Viper7000/Voltronic_MQTT/Version_1.1.md

# Принципиальная схема устройства версии 1.1 с исправленными ошибками

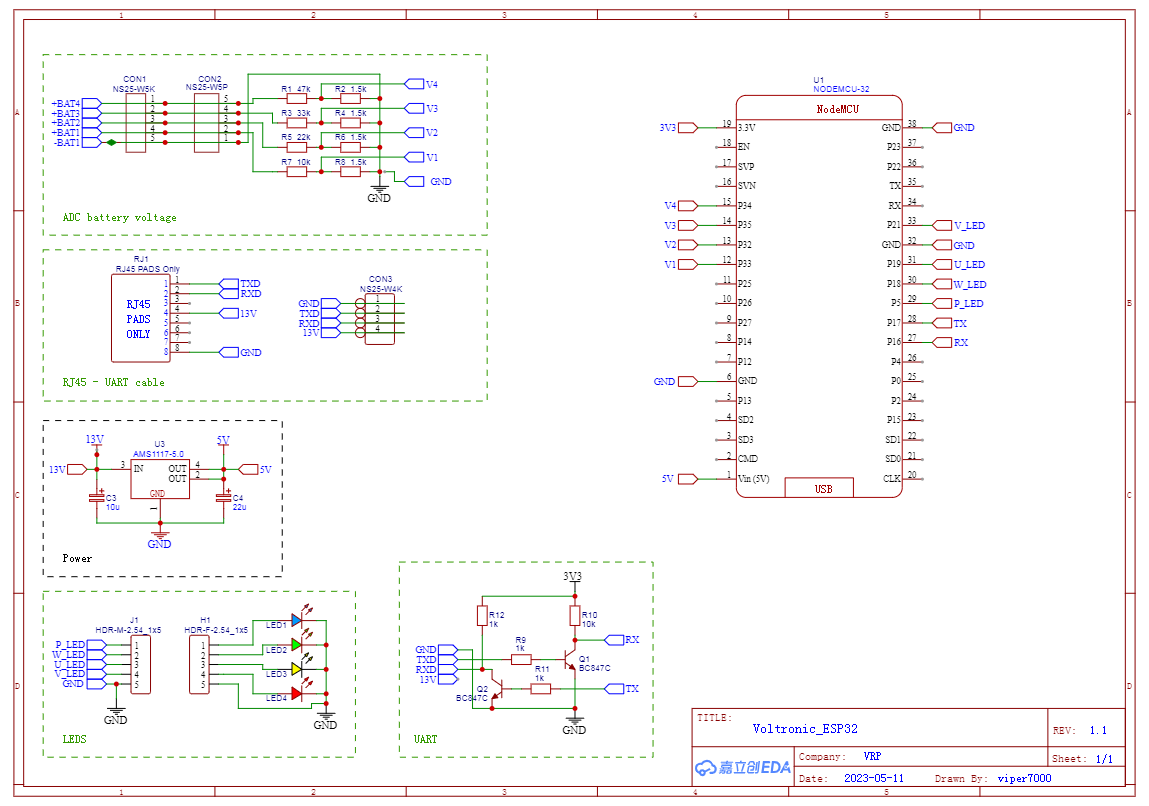
[picture p16: img/SCH_1.1.png]
схема принципиальная схема


## Печатная плата и сборка устройства

В папке prodaction есть [Gerber](production/Gerber_Voltronic_ESP32_v1.1.zip) для заказа печатной платы и [BOM](production/BOM_Board1_PCB1_2023-05-11.xlsx) файл компонентов.
Я заказзывал платы на https://jlcpcb.com . Изготовляем плату и собираем. Внешний вид платы на картинке.

плата вид впаты лицо
плата вид впаты изнанка

Для своего устройства я использовал корпус на DIN рейку шириной в 2 модуля. Спереди прозрачное стекло для установки вольтметров.

корпус корпус на DIN рейку

Внутрь на термоклей закрепил 4 вольтметра. Так же через отверстия вывел 4 диода. Закрепил тоже на термоклей.
Плата в сборе закрепляется на корпусе винтами.

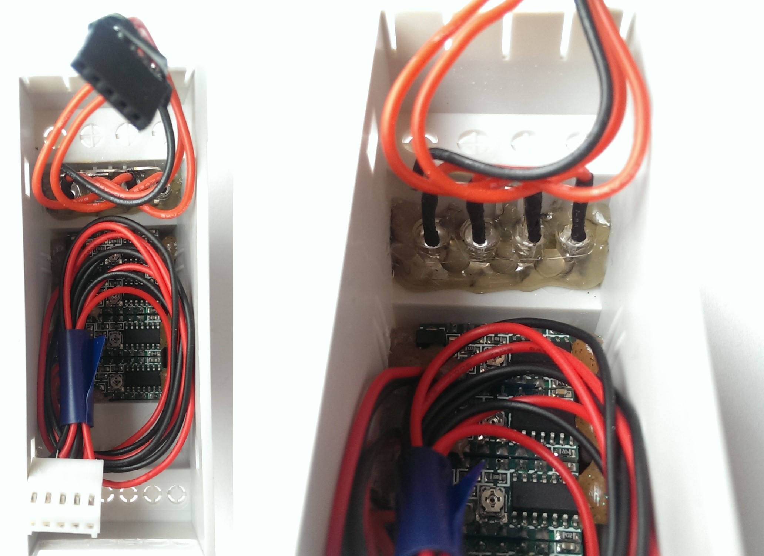
[picture p17: img/6.jpg]
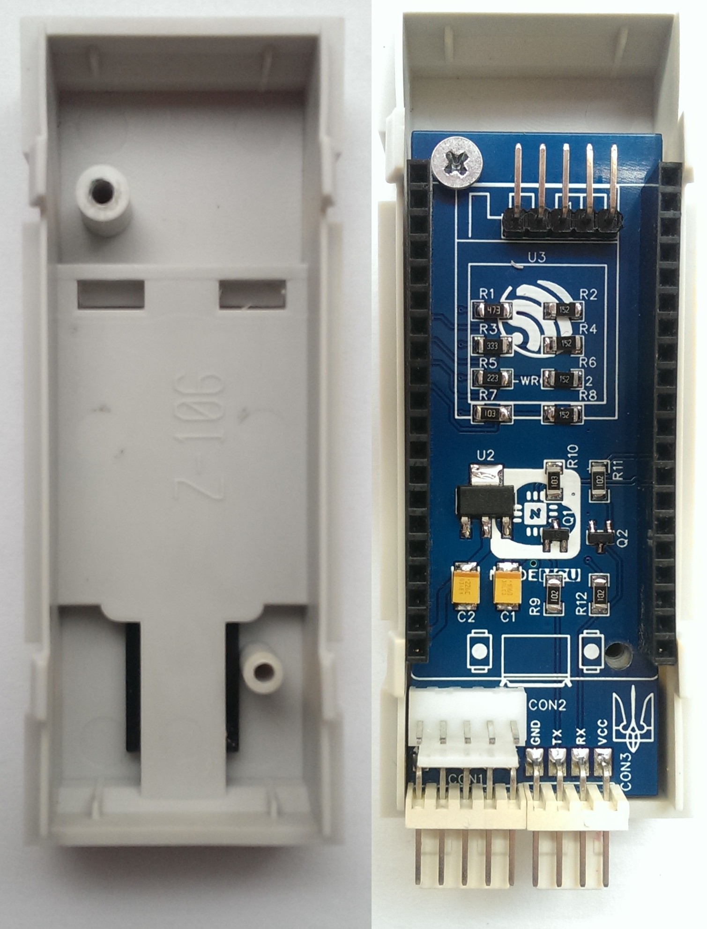
[picture p18: img/3.jpg]
 

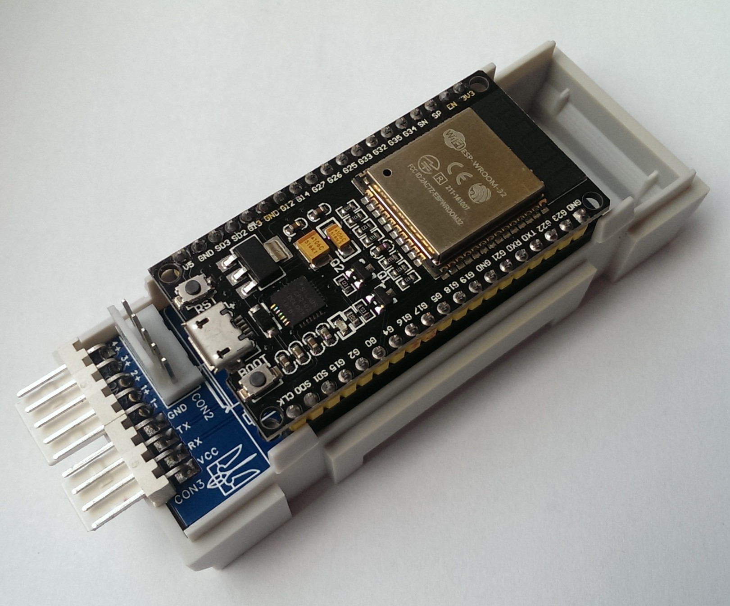
[picture p19: img/4.jpg]
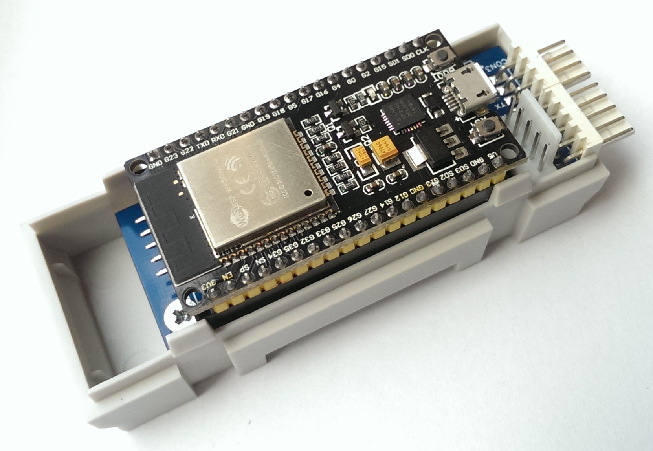
[picture p20: img/5.jpg]
 

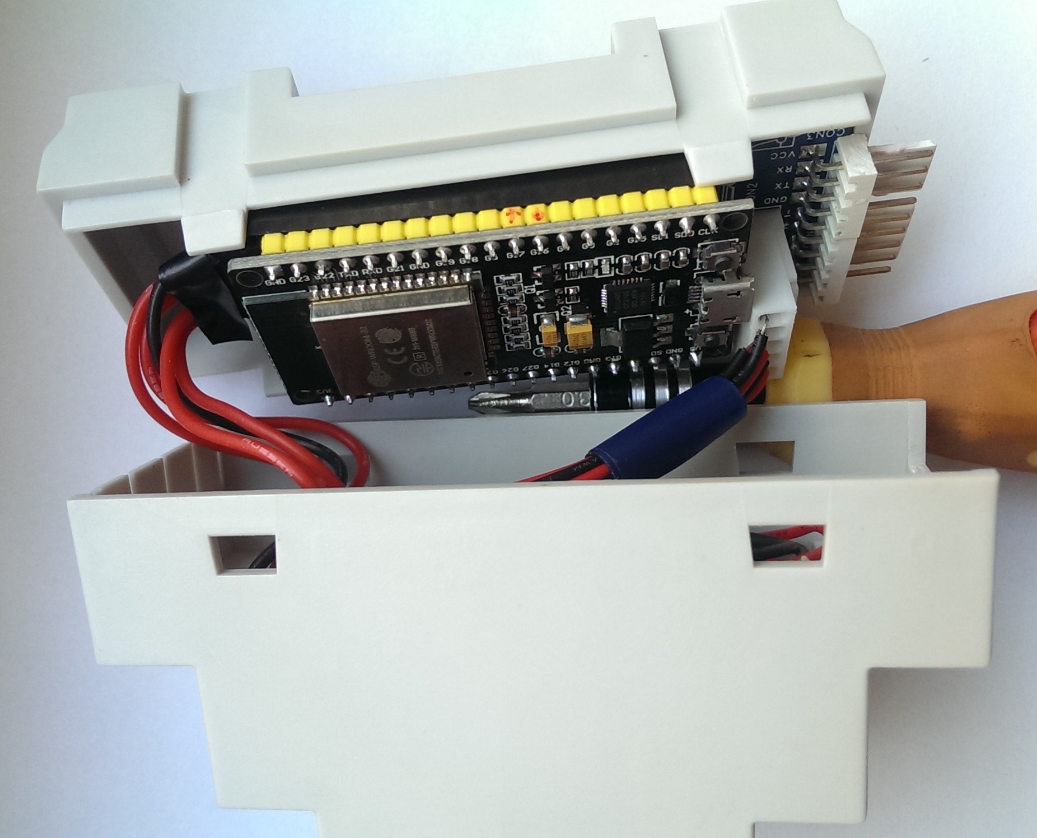
[picture p21: img/7.jpg]
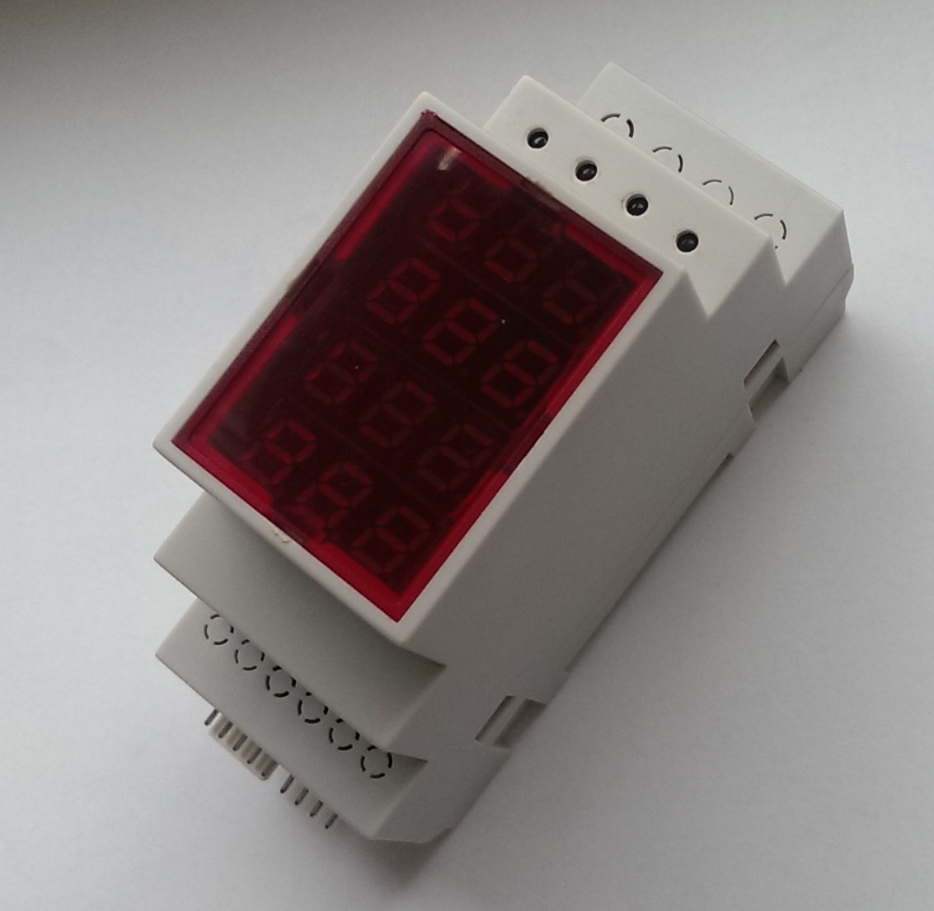
[picture p22: img/8.jpg]
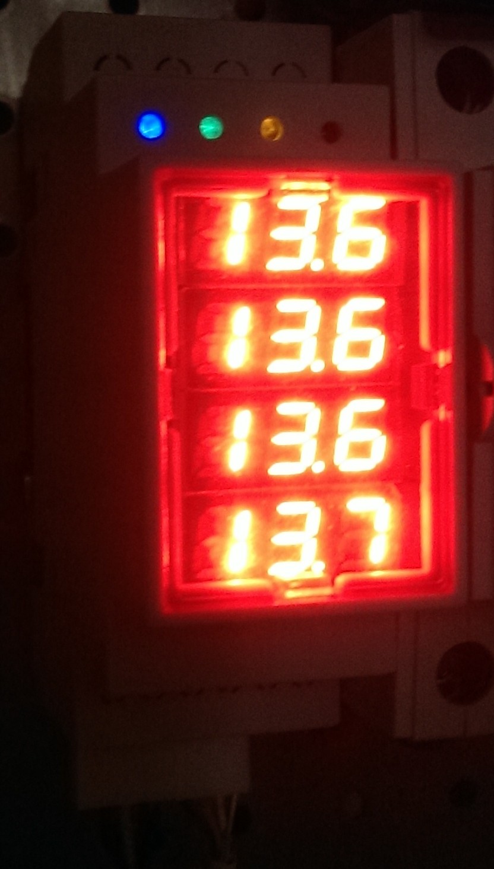
[picture p23: img/9.jpg]
  

## Настройка и пршивка ESP, заливка файлов
Для начала открываем [скетч](firmware/Voltronic_AJAX.ino) и прописываем свои данные. Обязательно не забудьте
* Название сети WiFi (WiFi SSID)
* пароль сети WiFi (WiFi Password)
* IP адрес MQTT сервера (MQTT Server IP)
* Название устройства MQTT, логин и пароль к вашему MQTT серверу (в строке client.connect("ESP_Voltronic", "mqtt", "mqtt"))
* Логин и пароль FTP (по умолчанию admin/1234)

Далее компилирует скерч и заливаем в ESP. 
> :memo: **Настройки должны быть:** ESP32 Dev Module, Default 4Mb with spiffs (1.2Mb APP/1.5Mb SPIFFS), 240Mhz

Запускаем ESP. Если диоды подключены и горит синий и зеленый диод - ESP подключилось к сети. Смотрим на роутере какой IP у ESP и подключаемся по FTP (не забываем логин/пароль). Я использую Total Commander.
После подключения заливаем на FTP файлы, что в папке [firmware/data](firmware/data)

## WEB интерфейс
WEB доступен по IP адресу устройства. При наведении на клетку есть информация по значению. Все сделано просто и наглядно. WEB работает через AJAX. Каждую секунду отправляет запросы данных. На нижней кнопке время с секундами. Время меняется при получении ответа от устройства (посекундно). Если время идет скачками или зависает - устройство не отвечает или плохая связь. При нажатии на кнопку со временем - перегружается WEB страница. Две иконки вверху: левая выводит информацию с устройства в формате json, правая переводит в настройки. В настройках переключаются режимы в блоке Voltronic Config. Там же есть апдейт прошивки. Для этого нужно скомпилировать скетч в bin формат: в Arduino Скетч/Экспорт бинарного файла.
Внешний вид WEB

 

## MQTT в Home Assistant

HA1 вид в MQTT 1

HA2 вид в MQTT 2

## В Home Assistant сделано так

HA3 Вид в Home Assistant

## Принцип работы и световая индикация
Есть 4 светодиода:
* Синий - питание. Тлеет при включении, светится если запустился проц. Тлеет все время - Нет запуска
* Зеленый - сеть. Моргает при подключении, светит если подключен, вспыхивает при отправке MQTT
* Желтый - UART. Светит порядка 1 сек при передаче по UART
* Красный - АЦП. Моргает при оцифровке напряжения батарей. Светит если батареи не подключены.
