Viper7000/Voltronic_MQTT/development.md

# Плата версии 1.0 в разработке

## Принципиальная схема платы
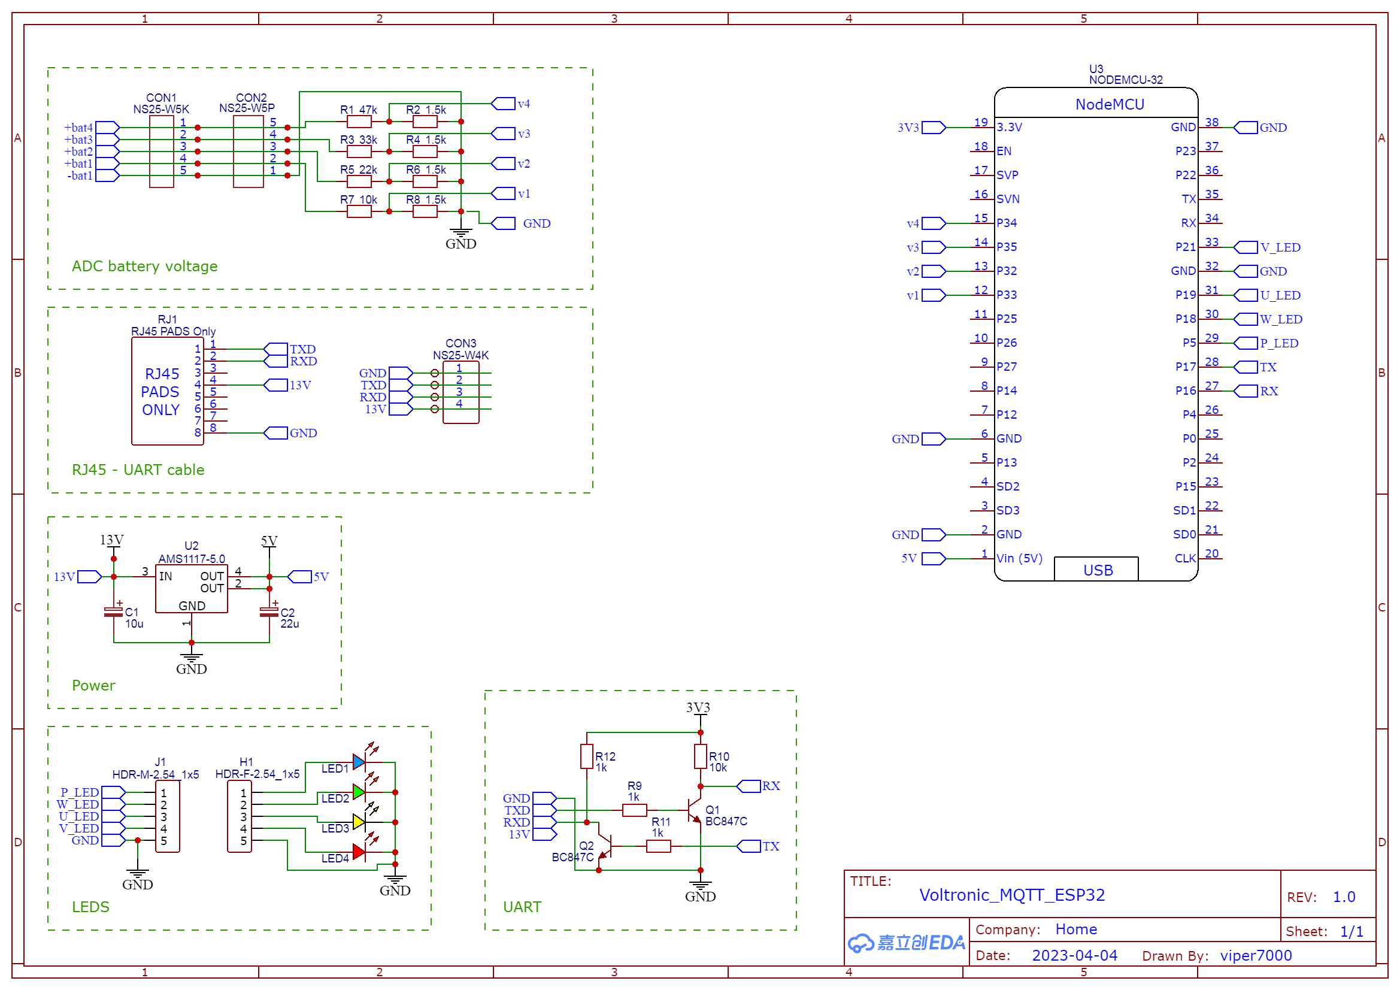
[picture p24: img/SCH.png]
схема


> :warning: **Предупреждение:** Это первоначальная схема устройства и она содержит ошибку! Рабочая схема версии 1.1 будет в описании проекта .
> 

## Разводка печатной платы
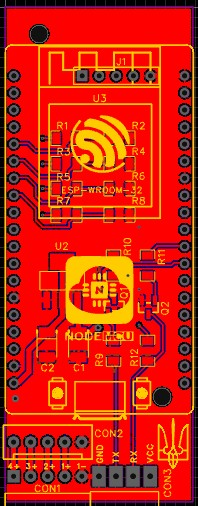
[picture p25: img/PCB1.jpg]
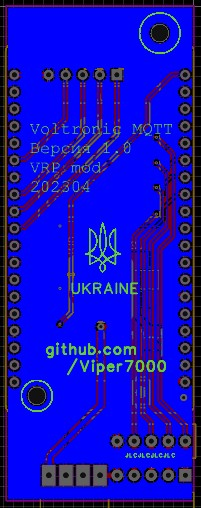
[picture p26: img/PCB2.jpg]
 

## Внешний вид платы
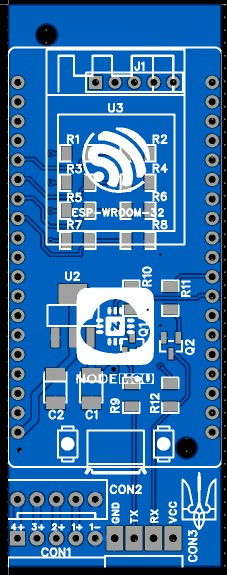
[picture p27: img/2D1.jpg]
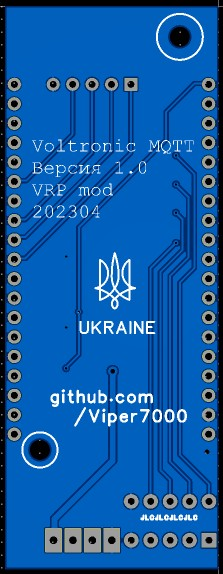
[picture p28: img/2D2.jpg]
 

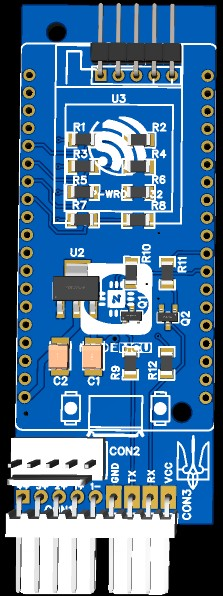
[picture p29: img/3D1.jpg]
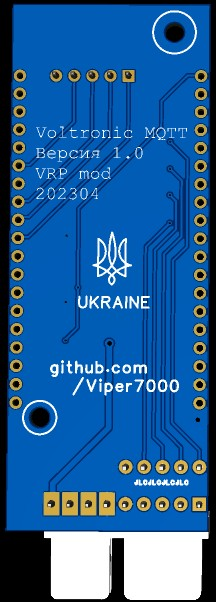
[picture p30: img/3D2.jpg]
 

## Платы полученные с завода
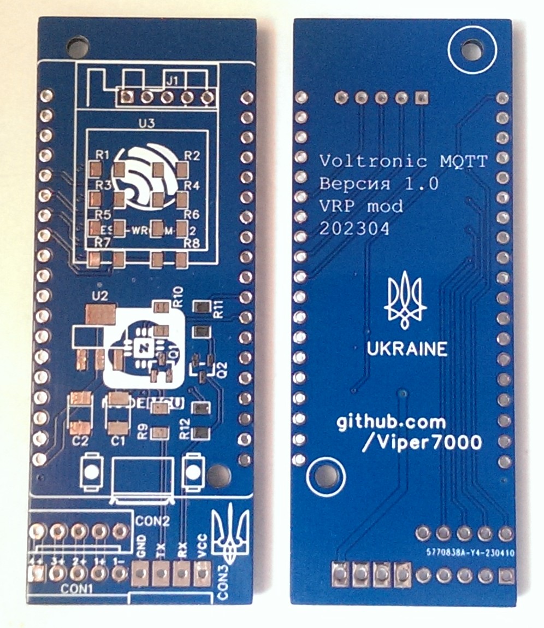
[picture p31: img/1.jpg]


## Сборка
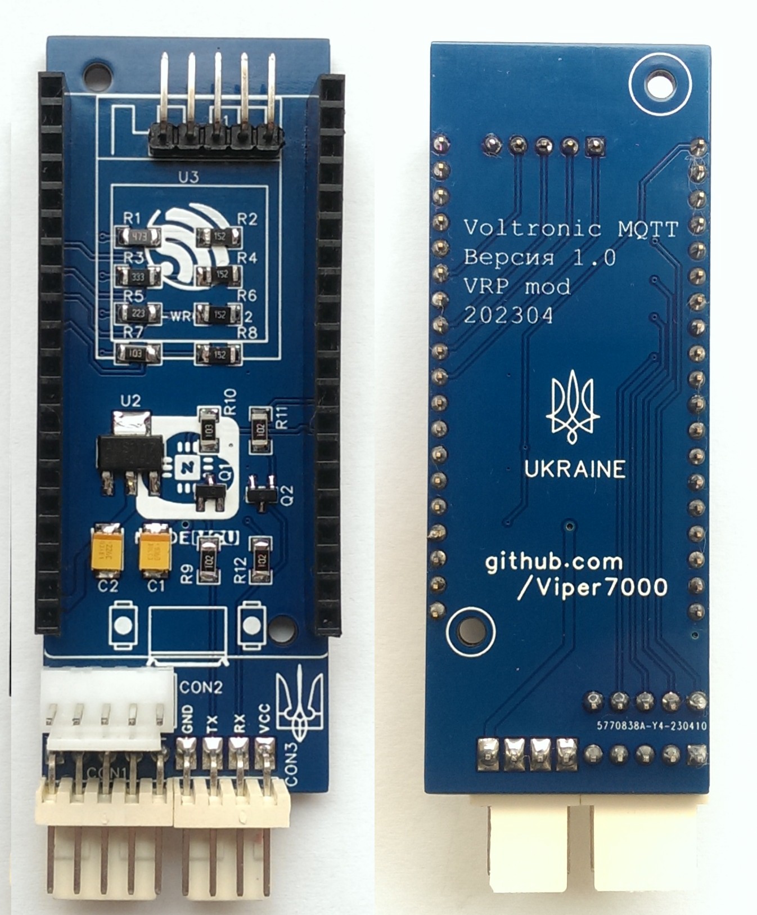
[picture p32: img/2.jpg]


## Тестирование и работа над ошибками
В собранном виде устройство не запустилось. Циклическая перезагрузка процессора. Ошибка: “flash read error”. Проверка показала, что один из выводов земли не подключен к земле. Тут и закралась ошибка. Вероятно в базе EasyEDA я взял пользовательский макет процессора ESP-32, в котором 2 вывод отмечен как GND. Проверил со своим процом - там тоже GND. А на самом деле там оказался вывод CMD.
Маркировка на самой плате процессора меня удивила. Может есть платы, где там и правда GND? :)

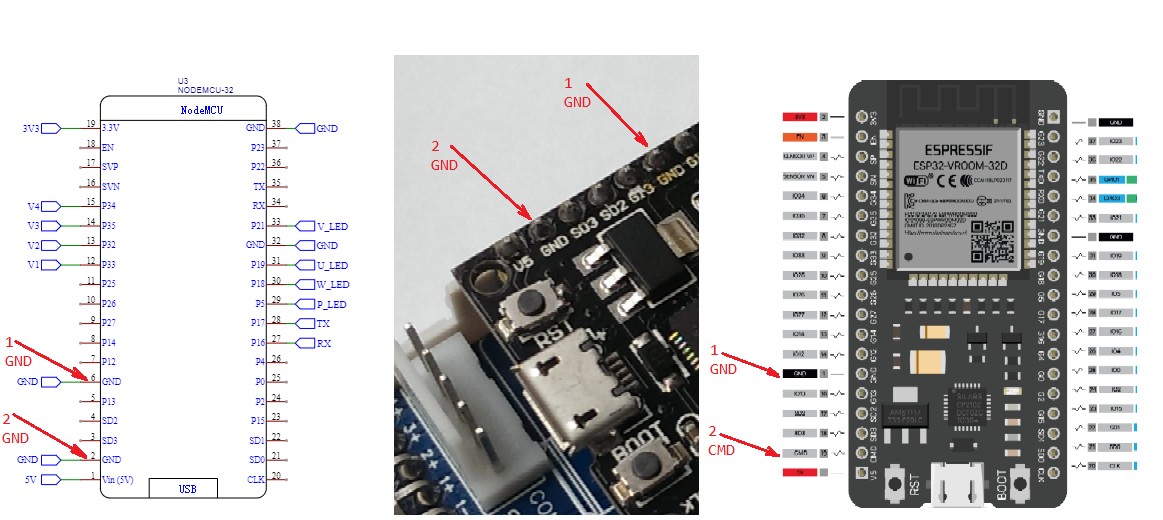
[picture p33: img/error.jpg]
ошибка


Можно просто вытянуть пин на межплатном переходе и он не будет соединен с платой. Для теста просто отогнул в сторону вывод CMD. 
Плата полностью рабочая.

> :memo: **Примечание:** Данная ошибка будет исправлена в версии 1.1 и здесь будут выложены исправленные Гербер файлы для заказа платы
