Viper7000/Voltronic_MQTT/firmware2.0/data/ico5.png

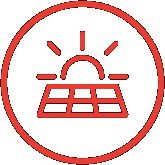
firmware2.0/data/ico5.png
