Viper7000/Voltronic_MQTT/firmware2.0/data/ico6.png

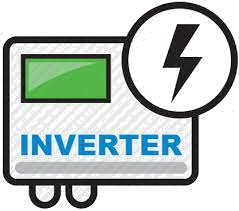
firmware2.0/data/ico6.png
