Viper7000/Voltronic_MQTT/firmware2.0/data/ico7.png

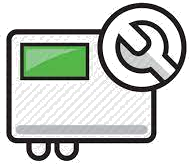
firmware2.0/data/ico7.png
