Viper7000/Voltronic_MQTT/production/BOM_Board1_PCB1_2023-05-11.xlsx

No. | Quantity | Comment | Designator | Footprint | Value | Manufacturer Part | Manufacturer | Supplier Part | Supplier
1 | 1 | 10u | C1 | CASE-B_3528
2 | 1 | 22u | C2 | CASE-B_3528
3 | 1 | NS25-W5K | CON1 | NS25-W5K |  | NS25-W3P |  | NS25-W3P | NINIGI
4 | 1 | NS25-W5P | CON2 | NS25-W5P |  | NS25-W5P |  | NS25-W5P | NINIGI
5 | 1 | NS25-W4K | CON3 | NS25-W4K_JD
6 | 1 | HDR-M-2.54_1x5 | J1 | HDR-M-2.54_1X5 |  |  |  | C358687 | LCSC
7 | 2 | BC847C-QR | Q1,Q2 | TO-236AB_L2.9-W1.3-P0.95-LS2.3-BR |  | BC847C-QR | Nexperia(安世) | C5336792 | LCSC
8 | 1 | 47k | R1 | R1206
9 | 4 | 1.5k | R2,R4,R6,R8 | R1206
10 | 1 | 33k | R3 | R1206
11 | 1 | 22k | R5 | R1206
12 | 2 | 10k | R7,R10 | R1206
13 | 3 | 1k | R9,R11,R12 | R1206
14 | 1 | AMS1117-5.0 | U2 | SOT-223-4_L6.5-W3.5-P2.30-LS7.0-BR |  | AMS1117-5.0 | PUOLOP(迪浦) | C351786 | LCSC
15 | 1 | NODEMCU-32 | U3 | NODEMCUESP32S |  | NodeMCU-32SLua | Ai-Thinker | C111436 | LCSC
